sitaurs/parcelboxx/image/gambar_penahan2.jpg

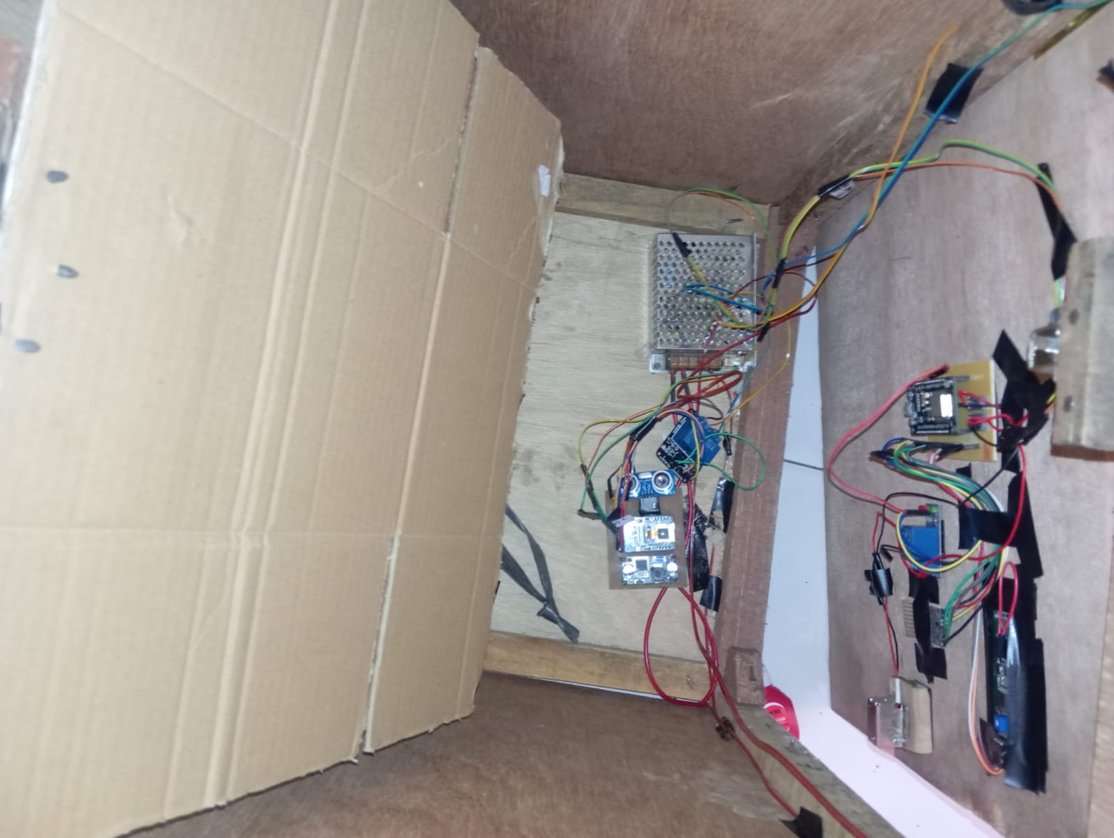
image/gambar_penahan2.jpg
