sitaurs/parcelboxx/image/gambar_paket_jatuh.jpg

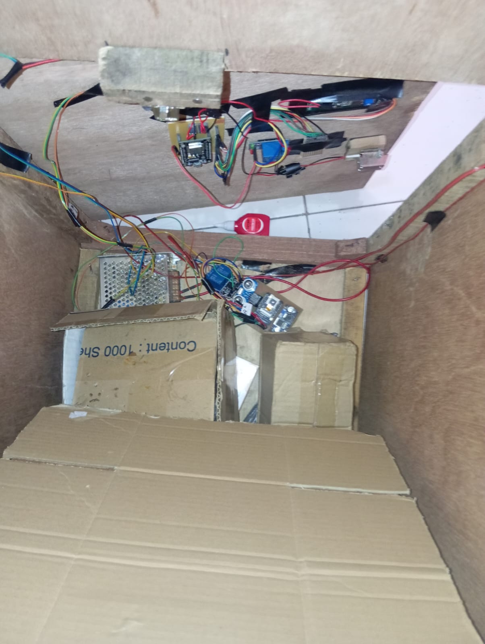
image/gambar_paket_jatuh.jpg
