sitaurs/parcelboxx/mobile-app/_DEPRECATED_DO_NOT_USE.md

# ⚠️ DEPRECATED - DO NOT USE

This folder contains the **OLD** mobile app and is **NO LONGER MAINTAINED**.

## Active Mobile App Location
The active mobile app is located at:
```
mobile-app-new/
```

## Why This Folder Exists
- Kept for reference and backup purposes
- May contain old code patterns that could be useful
- Will be archived or deleted in future cleanup

## Do NOT:
- ❌ Make changes to files in this folder
- ❌ Run `npm install` or `npm run dev` here
- ❌ Deploy from this folder

## Instead:
- ✅ Use `mobile-app-new/` for all development
- ✅ Run `cd mobile-app-new && npm run dev` for local development
- ✅ Build APK from `mobile-app-new/`

---
*Marked as deprecated on: December 16, 2025*
