sitaurs/parcelboxx/image/Gambar_penahan_kosong.jpg

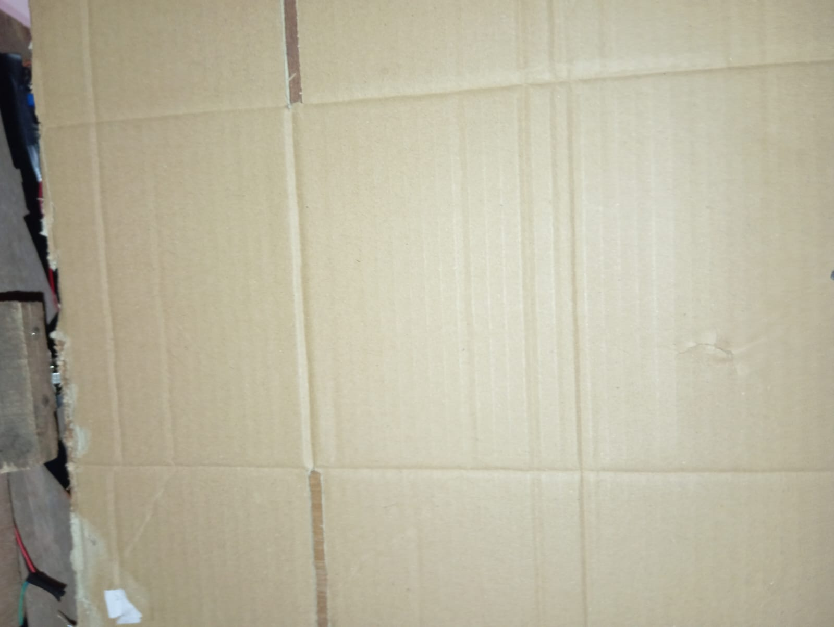
image/Gambar_penahan_kosong.jpg
