sitaurs/parcelboxx/image/gambar_penahan_paket2.jpg

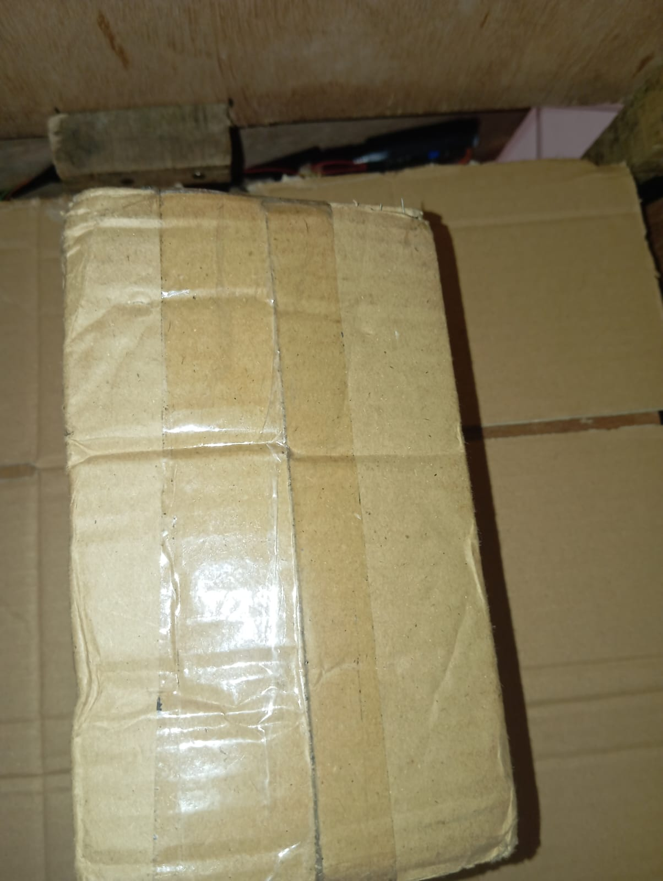
image/gambar_penahan_paket2.jpg
