sitaurs/parcelboxx/image/gambar_penahan_paket.jpg

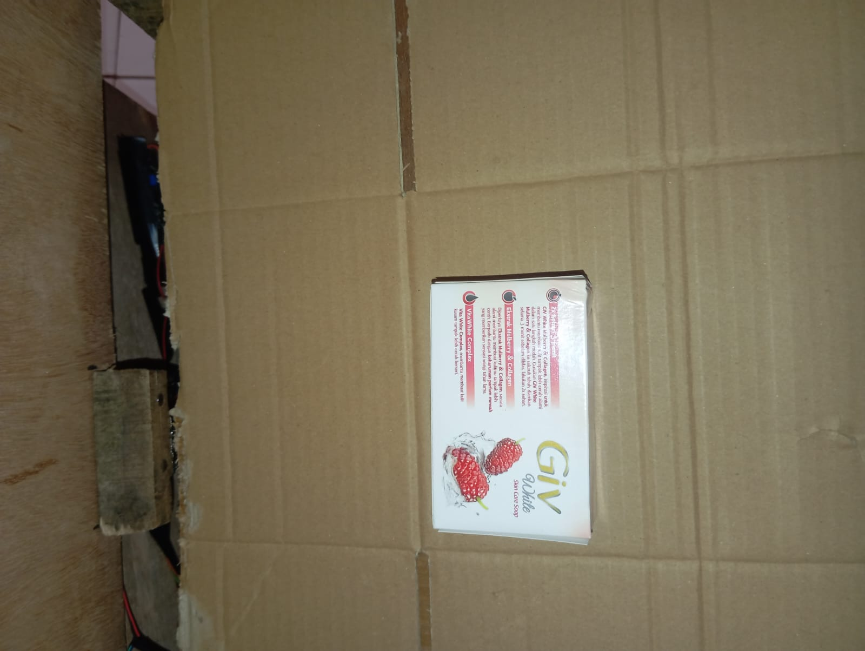
image/gambar_penahan_paket.jpg
