sitaurs/parcelboxx/(commit log)

2025-11-11 Fix TypeScript error: Add deviceStatus to Zustand store
2025-12-13 Update to VPS baru (3.27.0.139) - MQTT, Backend, GOWA, ESP32/ESP8266 configs
2025-12-13 feat: Add Gemini AI integration for intelligent package detection
    - Implement smart API key rotation system with 9 Gemini API keys
    - Add AIDetectionEngine with confidence scoring and retry mechanism
    - Implement DynamicIntervalManager for adaptive timing (IDLE/ACTIVE/COOLDOWN/BOOST)
    - Create comprehensive metrics and monitoring system with alerts
    - Update ESP32 firmware with periodic AI checks and MQTT controls
    - Add 10 new API endpoints for AI verification and management
    - HC-SR04 ultrasonic sensor now acts as boost trigger
    - Include complete documentation (quickstart, testing, summary)
    Features:
    - 135 requests/minute capacity (9 keys 15 RPM)
    - Adaptive check intervals: 30s idle, 15s activ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
2025-12-13 feat: add automatic retry with different API keys on failure
    ENHANCEMENT - Smart Retry Logic:
    - Automatic retry up to 3 attempts dengan API key berbeda
    - Exponential backoff (1s, 2s, 4s) between retries
    - Skip keys yang sudah error
    - Hanya retry untuk error yang recoverable:
    * RATE_LIMIT (429) - Try another key
    * SERVER_ERROR (500+) - Server issue
    * TIMEOUT - Network timeout
    CHANGES:
    - GeminiClient.js:
    * Added maxRetries = 3
    * Added retry loop dengan key rotation
    * Added shouldRetry() untuk determine retryable errors
    * Track usedKeys untuk avoid re-trying same key
    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
2025-12-16 v2.1.0: Major fixes - AI baseline, dark mode, API retry, ESP32 MQTT
    BACKEND:
    - [A1-C3] Link AIDetectionEngine to MQTT for baseline capture
    - [A1-M2] Flash default ms changed 150 -> 300ms
    - [A1-M3] Holder pulse capped to max 10 seconds
    - Added getAIEngine() export for MQTT integration
    - BaselinePhotoManager for 2-photo comparison
    FIRMWARE ESP32:
    - [A1-C1] Publish holder release event to MQTT
    - [A1-C2] Subscribe to baseline trigger topic
    - Added baseline capture handler with HTTP upload
    - New topics: BASELINE_TRIGGER, BASELINE_PHOTO, HOLDER_RELEASE
    MOBILE APP NEW:
    - [A2-M6] API retry mechanism with exponential backoff
    - [A2-M5] Configurable polling interval via API_CONFIG
    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
2025-12-16 fix(esp32): Fix MQTT publish compilation error and update MQTT credentials
    - Fix String concatenation in mqtt.publish() - use .c_str()
    - Update MQTT port from 1884 to 1883 (correct port)
    - Update MQTT password to SimplePass123 (matching VPS backend)
    - Fixes compilation error: no matching function for call to publish()
    Resolves: StringSumHelper conversion error in performAICheck()
2025-12-16 docs: Add comprehensive ESP32-CAM firmware guide
    - Hardware connection pinout with voltage divider warning
    - WiFiManager setup instructions (AP mode + reset)
    - MQTT topics reference (publish/subscribe)
    - Control commands examples (JSON payloads)
    - Settings configuration with limits
    - AI features and detection pipeline flow
    - Troubleshooting guide for common issues
    - Serial monitor expected output
    - Upload instructions for Arduino IDE
    Version: 2.1.1
2025-12-16 docs: Add complete system deployment status and checklist
    - Overview of all system components (backend, mobile, ESP32, ESP8266)
    - Credentials and configuration reference
    - System architecture diagram (ASCII)
    - MQTT topics structure
    - Deployment checklist with progress tracking
    - Pending tasks prioritized (high/medium/low)
    - Success metrics and completion status (85%)
    - Troubleshooting quick reference
    - Next actions for testing and production
    Status: Backend | Mobile | ESP32 | ESP8266
2025-12-16 fix(esp32): Add enhanced debugging and diagnostics for camera & ultrasonic issues
    CAMERA FIXES:
    - Add 3 retry attempts for camera capture with delays
    - Add camera test in setup() with byte count
    - Increase flash delay to 100ms for better lighting
    - Add detailed error messages
    ULTRASONIC FIXES:
    - Add pulseIn timeout debugging every 5 seconds
    - Show TRIG and ECHO pin states in debug
    - Add HC-SR04 test in setup() with warning
    - Increase TRIG pulse delay to 5us for stability
    DIAGNOSTICS:
    - Add 'diagnostic' MQTT command for hardware check
    - Reports camera, ultrasonic, wifi, mqtt status
    - Returns distance reading and free heap
    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
2025-12-16 fix(esp32): Fix camera busy issue and HC-SR04 ECHO stuck HIGH
    - Add 100ms delay after TCP connection close (httpAIVerify)
    - Increase retry delay: 200ms -> 500ms for camera recovery
    - Move debug output to retry loop to avoid duplicate
    - Add suggestion to reduce AI check interval
    HC-SR04 FIXES:
    - Re-initialize TRIG pin mode on every read
    - Increase initial LOW delay: 5us -> 10us
    - Add explicit pinMode(OUTPUT) before each pulse
    - Enhanced debug: detect ECHO stuck HIGH condition
    - Add diagnostic message for wiring issues
    ISSUE ANALYSIS:
    - Camera fails on 2nd capture: TCP connection not fully closed
    - HC-SR04 TRIG=0: Pin not pulsing (pinMode issue or conflict)
    - HC-SR04 ECHO=1: St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
2025-12-16 fix(esp32): Camera busy issue v2.1.4 - deinit/reinit recovery + 300ms TCP delay
2025-12-16 fix(esp32): Camera v2.1.5 - 60s interval, sensor reset, auto-disable after 3 failures
2025-12-16 fix(esp32): Camera v2.1.6 - I2C recovery, power cycle via PWDN pin for NACK errors
2025-12-16 fix(esp32): v2.1.7 - Reduce HC-SR04 warning spam 5s to 30s interval
2025-12-18 feat: Add detection mode selection (FULL_HCSR, FULL_GEMINI, BOTH)
    - Add detection.mode to settings.json schema
    - Update backend API to handle detection mode validation
    - Update ESP32 firmware to parse and apply detection mode
    - Create DetectionModeModal component for mobile app
    - Add Detection Mode option to Settings page
    - Disable rate limiter for demo/development
2025-12-18 fix: ESP32 compilation errors - use correct function names
2025-12-18 fix: detection mode logic - FULL_HCSR no photo, FULL_GEMINI ignore ultrasonic, BOTH combined
2025-12-18 fix: update ultrasonic range 5-27cm (package detected below 28cm holder level)
2025-12-18 feat: ESP32 publish ultrasonic data even when NaN with error details for debugging
2025-12-18 feat: change default detection mode to FULL_HCSR (ultrasonic only) for faster response
2025-12-19 fix: correct detection sequence - FOTO first, then 7s delay, then solenoid, then buzzer
2025-12-19 fix: ESP8266 MQTT password + add failed PIN attempt notifications
    [esp8266.ino]
2025-12-19 fix: lockPulseMs non-blocking to prevent flash LED interference
2025-12-19 feat: solenoid pulse pattern - 2x 1sec pulse + 8sec final hold
2025-12-20 Fix: Bypass Sharp for ESP32-CAM JPEG + WhatsApp notification
    - Skip Sharp processing for original photo save (direct fs.writeFileSync)
    - Add try-catch for thumbnail generation (fallback to original)
    - Call sendWhatsAppNotification immediately after save
    - Add NO HOLDER firmware (esp32-no-holder.ino)
    - Fixes 'Input buffer contains unsupported image format' error
    [esp32-no-holder.ino]
2025-12-20 Improve ESP32-CAM photo quality for both firmwares
    BOTH FIRMWARES (esp32.ino + esp32-no-holder.ino):
    - Upgrade to VGA 640x480 (from QVGA 320x240) for better quality
    - Adaptive PSRAM/DRAM mode with manual init fallback
    - UXGA 1600x1200 if PSRAM available (high quality)
    - VGA 640x480 if DRAM only (good quality, 4x better than QVGA)
    - Clock speed 20MHz (from 10MHz) for stability
    - JPEG quality 10 (high compression)
    - Flash delay 200ms for better exposure
    - Detailed capture logging with attempt numbers
    - Success feedback with WhatsApp notification confirmation
    - Photo size: 15-25 KB (VGA) vs 80-150 KB (UXGA)
    - Works reliably on ESP32-CAM clone modules without PSRAM
    [esp32-no-holder.ino]
2025-12-20 feat: add buzzer enable/disable feature - firmware, app, backend
    [esp32_cam-with-holder.ino]
2025-12-20 fix: repair corrupted firmware code in esp32-no-holder.ino
    [esp32-no-holder.ino]
2025-12-20 fix: string concatenation syntax in ensureMQTT
    [esp32-no-holder.ino]
2025-12-20 fix: camera capture failure after first detection + add settle delay before photo
    [esp32-no-holder.ino]
2025-12-20 fix: first detection after boot always failing - add camera warmup and buffer flush
    [esp32-no-holder.ino]
2025-12-20 fix: camera warmup with flash and multiple warmup captures before actual photo
    [esp32-no-holder.ino]
2025-12-20 fix: pre-warm camera at boot for instant first detection capture
    [esp32-no-holder.ino]
2025-12-20 fix: ESP8266 MQTT port 1883 and backend PIN sync to 432432
    [esp8266.ino]
2025-12-20 feat: remove authentication system from mobile app (login, password, PIN lock) - keep door lock PIN only
2025-12-20 Fix 4 masalah: hapus solenoid holder test, tambah change door PIN, fix gallery images, hapus detection mode card
    [esp8266.ino]
2025-12-20 Fix: Remove Release Holder, fix image URLs, fix backend door-pin
2025-12-20 Fix: ESP8266 default PIN sync dengan backend (358358)
    [esp8266.ino]
2025-12-20 Update: Hapus Detection Mode dari Settings, setup logo untuk Capacitor Android
2025-12-20 Add: SplashScreen animasi 5 detik, page transitions, Card animations, floating effects di semua halaman
2025-12-20 Fix: Improve buzzer stop responsiveness - MQTT loop setiap 50ms, tambah debugging logs
    [esp32-no-holder.ino]
2025-12-20 Fix: Buzzer stop tidak berhenti - Dual command (buzzer stop + general stop), MQTT loop 50ms di firmware, debug logs
2025-12-20 Refactor: DeviceControl -> DeviceSettings + DeviceTest - Settings: Buzzer ON/OFF + Threshold Slider (10-50cm) - Test: Camera/Flash + Buzzer only - Hapus Release Holder, Door Lock, sensor status dari 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
2025-12-20 Fix: TypeScript errors + Add threshold slider support to ESP32 firmware - Add diagnostic API method - Remove size prop from Button (use className) - ESP32 subscribe to settings/set topic for threshol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
    [esp32-no-holder.ino]
2025-12-20 Build: Generate APK with Capacitor Android platform
    - Install @capacitor/android package
    - Add Android platform with npx cap add android
    - Fix Java 21 compatibility issues (patched to Java 17)
    - Build production web bundle (dist/)
    - Generate debug APK: SmartParcel-v1.0.0-debug.apk (8.3 MB)
    - Add BUILD_NOTES.md with complete build documentation
    Features included:
    - Device Settings: Buzzer toggle + Threshold slider (10-50cm)
    - Device Test: Camera/Flash + Buzzer test only
    - Full stack threshold support (frontend backend MQTT ESP32)
    - Framer Motion animations (5s splash, page transitions)
    Note: Default Capacitor icons used. Custom logo integration pending.
2025-12-20 Setup: Create app_build directory for Capacitor builds
    - Create app_build/ folder as dedicated build output directory
    - Copy APK with date in filename: SmartParcel-v1.0.0-debug-20251220.apk
    - Copy app icon: smartparcel-icon.ico (from llogo folder)
    - Add README.md with complete build instructions and history
    Build naming convention: SmartParcel-v{version}-{buildType}-{YYYYMMDD}.apk
2025-12-20 Build: APK with custom logo and splash screens
    - Generate Android icons from logo.png using capacitor-assets
    - Create 74 assets: adaptive icons, round icons, splash screens (light/dark)
    - All densities: ldpi, mdpi, hdpi, xhdpi, xxhdpi, xxxhdpi
    - Rebuild APK: SmartParcel-v1.0.0-debug-20251220-with-logo.apk (9.59 MB)
    - Add resources/icon.png for future icon generation
    - Update app_build README with build comparison
    Icon generated from: public/logo.png
    Total assets: 1.88 MB (icons + splash screens)
2025-12-20 Fix: Android network security for VPS HTTP backend connection
    Problem: App tidak konek ke backend VPS (3.27.11.106:9090) after install
    Root cause: Android blocks cleartext HTTP traffic by default
    Changes:
    - Update capacitor.config.ts: androidScheme http, cleartext true
    - Add network_security_config.xml: Allow HTTP to 3.27.11.106
    - Update AndroidManifest.xml: usesCleartextTraffic + networkSecurityConfig
    - Rebuild APK: SmartParcel-v1.0.0-debug-20251220-2314-network-fixed.apk (9.59 MB)
    - Add NETWORK_FIX_GUIDE.md with troubleshooting steps
    Now app can connect to HTTP backend on VPS.
2025-12-21 Fix: Numeric keyboard for PIN + Status bar safe area
    UI Fixes:
    1. Numeric Keyboard for PIN inputs
    - Change input type from 'password' to 'tel'
    - Force numeric keyboard on Android with inputMode='numeric' + pattern='[0-9]*'
    - Applies to UnlockDoorModal and ChangeDoorPinModal
    2. Status Bar Safe Area
    - Add pt-safe class with env(safe-area-inset-top) CSS
    - Apply to Layout component to prevent overlap with Android status bar
    - Update styles.xml: transparent status bar + draw under system bars
    - Adds 20px default padding for Android devices
    Build: SmartParcel-v1.0.0-debug-20251221-0950-ui-fixes.apk (9.87 MB)
2025-12-24 Fix: PIN endpoint + WhatsApp phone format
